neilenns/CJ4-MFD-Menu-Panel/reference.png

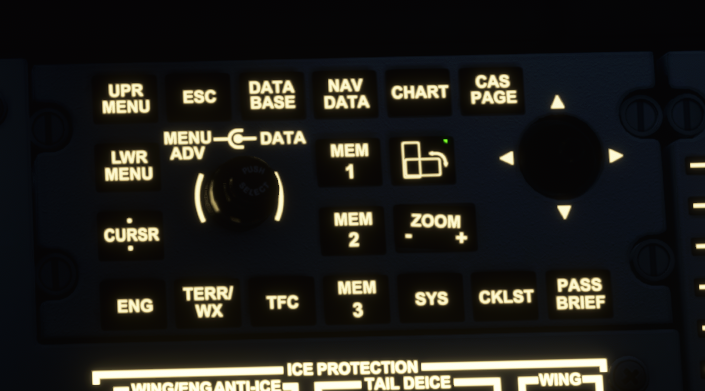
reference.png
