neilenns/CJ4-MFD-Menu-Panel/README.md

# CJ4 MFD menu panel for use with MobiFlight
