neilenns/CJ4-MFD-Menu-Panel/3D models/5-way switch.step

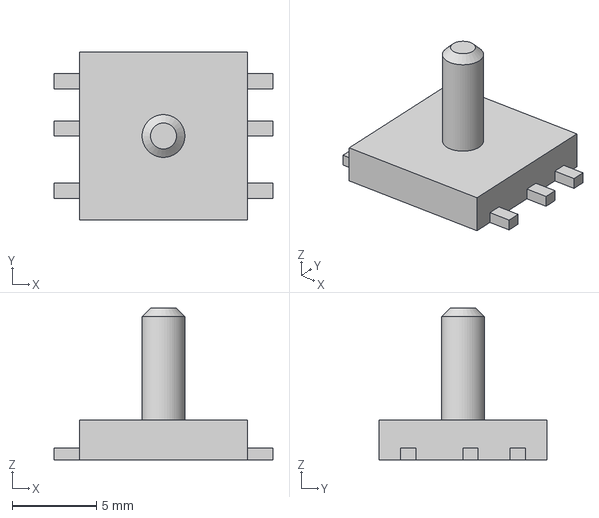
[picture p2: CAD file, 2022-09-28]
3D models/5-way switch.step
13.0 x 10.0 x 9.00 mm
