neilenns/CJ4-MFD-Menu-Panel/eec.models/ALPS_-_EC11EBB24C03.step

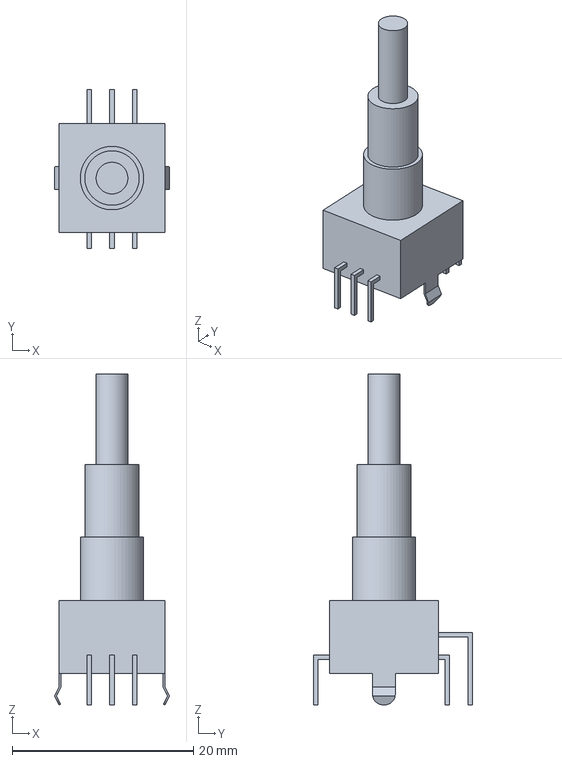
[picture p3: CAD file, 2021-12-02]
eec.models/ALPS_-_EC11EBB24C03.step
12.7 x 17.5 x 36.5 mm
