neilenns/CJ4-MFD-Menu-Panel/3D models/6x6 LED button.step

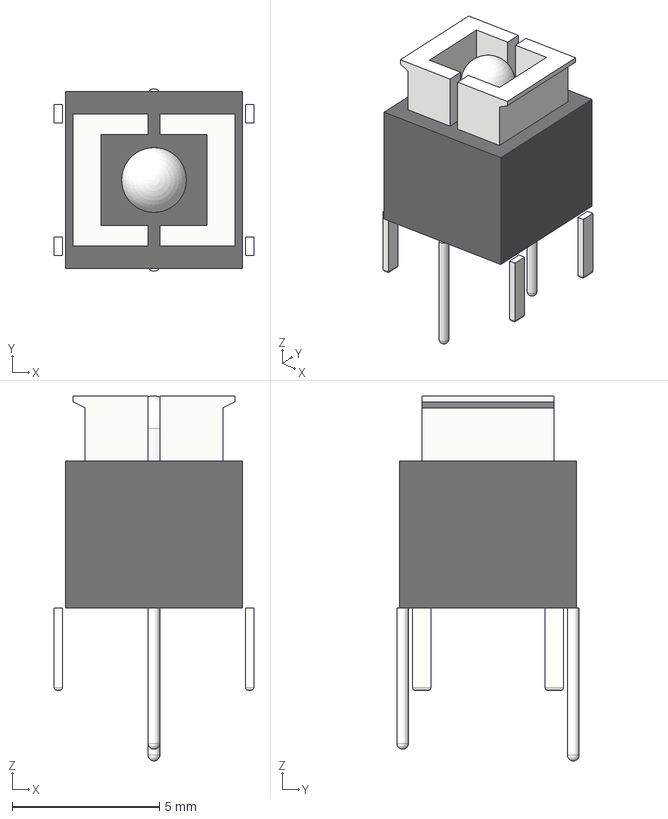
[picture p5: CAD file, 2022-09-28]
3D models/6x6 LED button.step
6.78 x 6.20 x 12.4 mm
