neilenns/CJ4-MFD-Menu-Panel/CJ4-MFD-Menu-Panel.kicad_pcb

## KiCad design CJ4-MFD-Menu-Panel.kicad_pcb (2022-09-28)

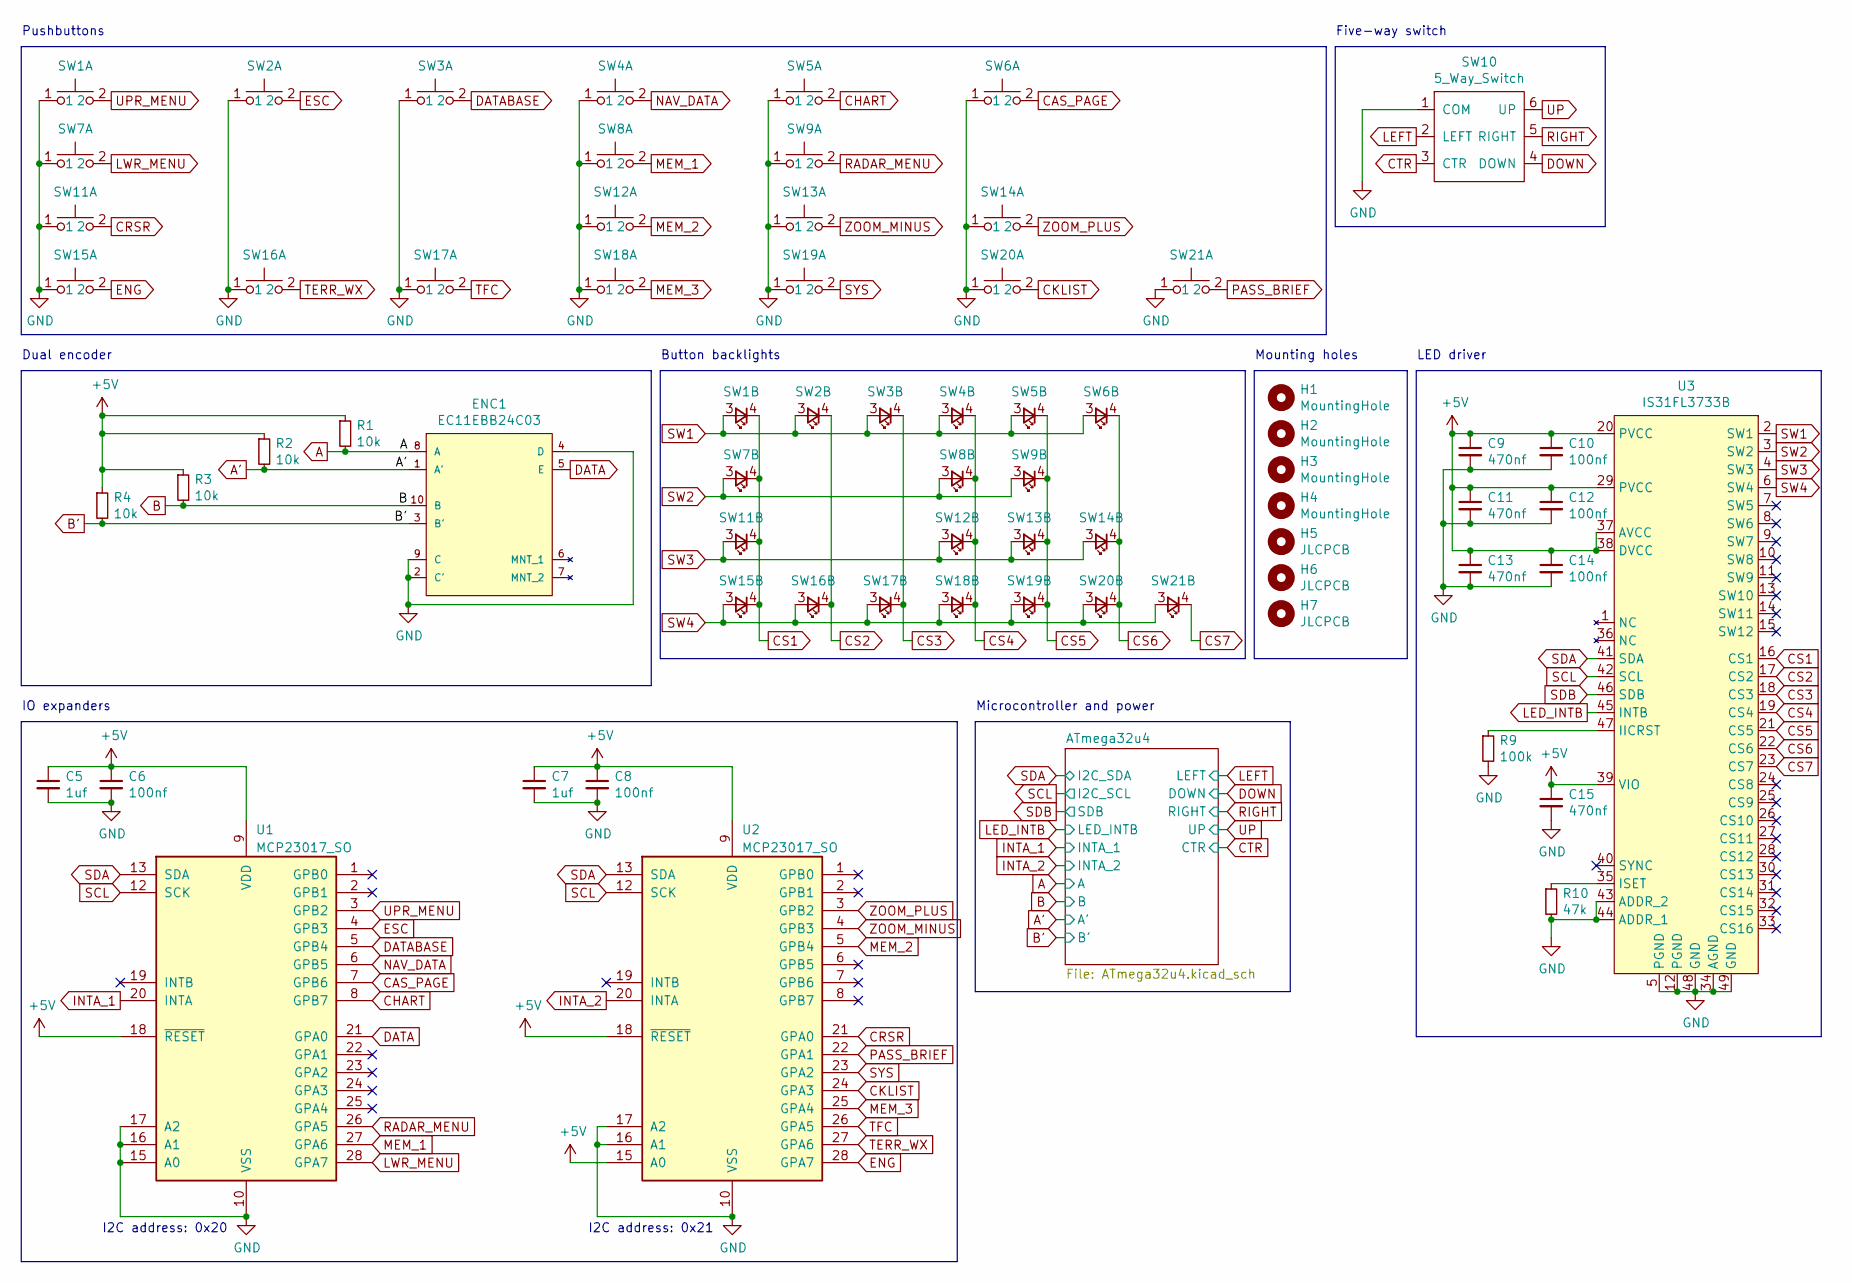
[picture p6: schematic CJ4-MFD-Menu-Panel.kicad_sch]

Parts:
C5, C7: 1uf; Perfect_0402; JLC 0402
C6, C8, C10, C12, C14: 100nf; Perfect_0402; JLC 0402
C9, C11, C13, C15: 470nf; Perfect_0402; JLC 0402
ENC1: EC11EBB24C03; ALPS-EC11EBB24C03-0; Rating 10mA 5VDC; mouser part number 688-EC11EBB24C03
H1, H2, H3, H4: MountingHole; MountingHole_3.2mm_M3; JLC DNP
H5, H6, H7: JLCPCB; JLCPCB_Tooling_Hole; JLC DNP
R1, R2, R3, R4: 10k; Perfect_0402; JLC 0402
R9: 100k; Perfect_0402; JLC 0402
R10: 47k; Perfect_0402; JLC 0402
SW1, SW2, SW3, SW4, SW5, SW6, SW7, SW8, SW9, SW11, SW12, SW13, SW14, SW15, SW16, SW17, SW18, SW19, SW20, SW21: SW_Push_LED; SW_PUSH_6mm; JLC DNP
SW10: 5_Way_Switch; JLC DNP
U1, U2: MCP23017_SO; SOIC-28W_7.5x17.9mm_P1.27mm; JLC DNP
U3: IS31FL3733B; TQFP-48-1EP_7x7mm_P0.5mm_EP5x5mm_ThermalVias; JLC DNP

Connections:
+5V: C5.1, C6.1, C7.1, C8.1, C9.1, C10.1, C11.1, C12.1, C13.1, C14.1, C15.1, R1.1, R2.1, R3.1, R4.1, U1.9 (VDD), U1.18 (~RESET), U2.9 (VDD), U2.15 (A0), U2.18 (~RESET), U3.20 (PVCC), U3.29 (PVCC), U3.37 (AVCC), U3.38 (DVCC), U3.39 (VIO); also elsewhere on the board
A: ENC1.8 (A), R1.2; also elsewhere on the board
A': ENC1.1 (A'), R2.2; also elsewhere on the board
B: ENC1.10 (B), R3.2; also elsewhere on the board
B': ENC1.3 (B'), R4.2; also elsewhere on the board
CAS_PAGE: SW6.2, U1.7 (GPB6)
CHART: SW5.2, U1.8 (GPB7)
CKLIST: SW20.2, U2.24 (GPA3)
CRSR: SW11.2, U2.21 (GPA0)
CS1: SW1.4, SW7.4, SW11.4, SW15.4, U3.16 (CS1)
CS2: SW2.4, SW16.4, U3.17 (CS2)
CS3: SW3.4, SW17.4, U3.18 (CS3)
CS4: SW4.4, SW8.4, SW12.4, SW18.4, U3.19 (CS4)
CS5: SW5.4, SW9.4, SW13.4, SW19.4, U3.21 (CS5)
CS6: SW6.4, SW14.4, SW20.4, U3.22 (CS6)
CS7: SW21.4, U3.23 (CS7)
CTR: SW10.3 (CTR); also elsewhere on the board
DATABASE: SW3.2, U1.5 (GPB4)
DOWN: SW10.4 (DOWN); also elsewhere on the board
ENG: SW15.2, U2.28 (GPA7)
ESC: SW2.2, U1.4 (GPB3)
E_BTN: ENC1.5 (E), U1.21 (GPA0)
GND: C5.2, C6.2, C7.2, C8.2, C9.2, C10.2, C11.2, C12.2, C13.2, C14.2, C15.2, ENC1.2 (C'), ENC1.4 (D), ENC1.9 (C), R9.2, R10.2, SW1.1, SW2.1, SW3.1, SW4.1, SW5.1, SW6.1, SW7.1, SW8.1, SW9.1, SW10.1 (COM), SW11.1, SW12.1, SW13.1, SW14.1, SW15.1, SW16.1, SW17.1, SW18.1, SW19.1, SW20.1, SW21.1, U1.10 (VSS), U1.15 (A0), U1.16 (A1), U1.17 (A2), U2.10 (VSS), U2.16 (A1), U2.17 (A2), U3.5 (PGND), U3.12 (PGND), U3.34 (AGND), U3.43 (ADDR_2), U3.44 (ADDR_1), U3.48 (GND), U3.49 (GND); also elsewhere on the board
INTA_1: U1.20 (INTA); also elsewhere on the board
INTA_2: U2.20 (INTA); also elsewhere on the board
LED_INTB: U3.45 (INTB); also elsewhere on the board
LEFT: SW10.2 (LEFT); also elsewhere on the board
LWR_MENU: SW7.2, U1.28 (GPA7)
MEM_1: SW8.2, U1.27 (GPA6)
MEM_2: SW12.2, U2.5 (GPB4)
MEM_3: SW18.2, U2.25 (GPA4)
NAV_DATA: SW4.2, U1.6 (GPB5)
unnamed: R9.1, U3.47 (IICRST)
unnamed: R10.1, U3.35 (ISET)
PASS_BRIEF: SW21.2, U2.22 (GPA1)
RADAR_MENU: SW9.2, U1.26 (GPA5)
RIGHT: SW10.5 (RIGHT); also elsewhere on the board
SCL: U1.12 (SCK), U2.12 (SCK), U3.42 (SCL); also elsewhere on the board
SDA: U1.13 (SDA), U2.13 (SDA), U3.41 (SDA); also elsewhere on the board
SDB: U3.46 (SDB); also elsewhere on the board
SW1: SW1.3, SW2.3, SW3.3, SW4.3, SW5.3, SW6.3, U3.2 (SW1)
SW2: SW7.3, SW8.3, SW9.3, U3.3 (SW2)
SW3: SW11.3, SW12.3, SW13.3, SW14.3, U3.4 (SW3)
SW4: SW15.3, SW16.3, SW17.3, SW18.3, SW19.3, SW20.3, SW21.3, U3.6 (SW4)
SYS: SW19.2, U2.23 (GPA2)
TERR_WX: SW16.2, U2.27 (GPA6)
TFC: SW17.2, U2.26 (GPA5)
UP: SW10.6 (UP); also elsewhere on the board
UPR_MENU: SW1.2, U1.3 (GPB2)
ZOOM_MINUS: SW13.2, U2.4 (GPB3)
ZOOM_PLUS: SW14.2, U2.3 (GPB2)

Notes on the sheet:
Pushbuttons
IO expanders
LED driver
Button backlights
Microcontroller and power
Five-way switch
Dual encoder
I2C address: 0x20
I2C address: 0x21
Mounting holes

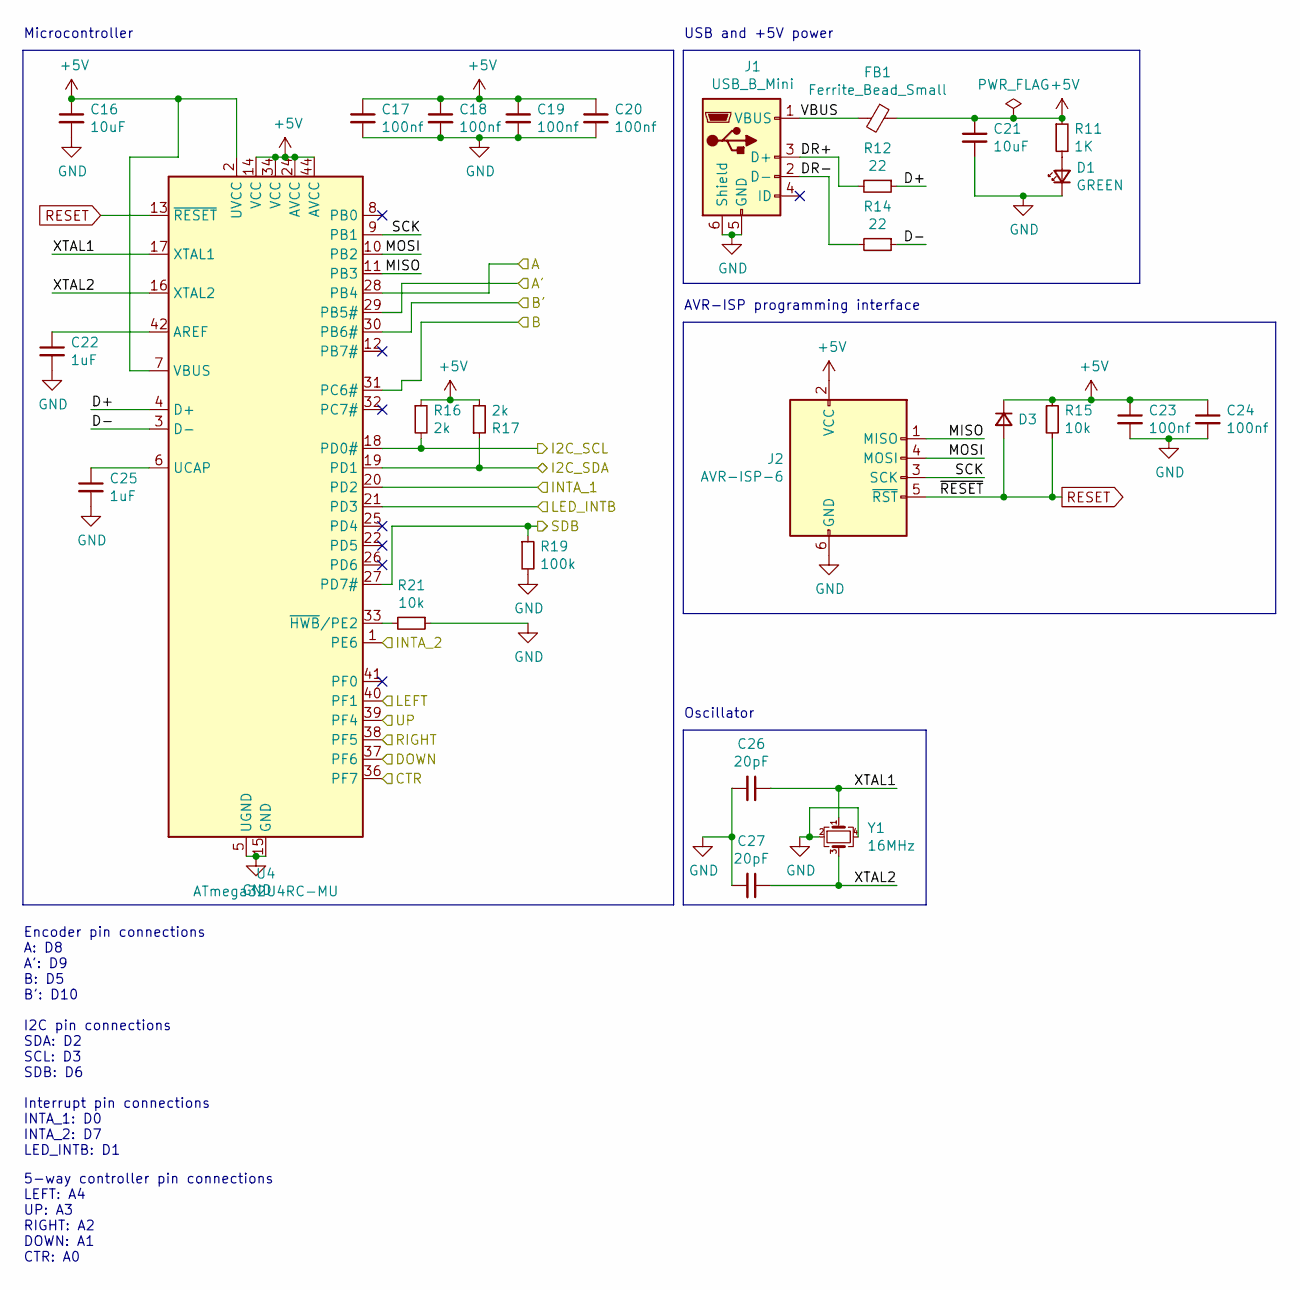
[picture p7: schematic ATmega32u4.kicad_sch]

Parts:
C16, C21: 10uF; Perfect_0402; JLC 0402
C17, C18, C19, C20, C23, C24: 100nf; Perfect_0402; JLC 0402
C22, C25: 1uF; Perfect_0402; JLC 0402
C26, C27: 20pF; Perfect_0402; JLC 0402
D1: GREEN; LED_0805_2012Metric_Pad1.15x1.40mm_HandSolder; JLC DNP
D3: D_Small; D_SOD-323F; JLC SOD-323F
FB1: Ferrite_Bead_Small; C_0805_2012Metric; JLC 0805
J1: USB_B_Mini; USB_B_Mini_Amphenol_UE25BE5510H; JLC DNP
J2: AVR-ISP-6; Tag-Connect_TC2030-IDC-NL_2x03_P1.27mm_Vertical; JLC DNP
R11: 1K; Perfect_0402; JLC 0402
R12, R14: 22; Perfect_0402; JLC 0402
R15, R21: 10k; Perfect_0402; JLC 0402
R16, R17: 2k; R_0805_2012Metric_Pad1.20x1.40mm_HandSolder; JLC 0805
R19: 100k; Perfect_0402; JLC 0402
U4: ATmega32U4RC-MU; QFN-44-1EP_7x7mm_P0.5mm_EP5.2x5.2mm; JLC DNP
Y1: 16MHz; Crystal_SMD_3225-4Pin_3.2x2.5mm; JLC SMD-CRY-3225_4P

Connections:
+5V: C16.1, C17.1, C18.1, C19.1, C20.1, C21.1, C23.1, C24.1, D3.1 (K), FB1.1, J2.2 (VCC), R11.1, R15.1, R16.1, R17.2, U4.2 (UVCC), U4.7 (VBUS), U4.14 (VCC), U4.24 (AVCC), U4.34 (VCC), U4.44 (AVCC); also elsewhere on the board
/ATmega32u4/D+: R12.1, U4.4 (D+)
/ATmega32u4/D-: R14.1, U4.3 (D-)
/ATmega32u4/DR+: J1.3 (D+), R12.2
/ATmega32u4/DR-: J1.2 (D-), R14.2
/ATmega32u4/MISO: J2.1 (MISO), U4.11 (PB3)
/ATmega32u4/MOSI: J2.4 (MOSI), U4.10 (PB2)
/ATmega32u4/SCK: J2.3 (SCK), U4.9 (PB1)
/ATmega32u4/VBUS: FB1.2, J1.1 (VBUS)
/ATmega32u4/XTAL1: C26.1, U4.17 (XTAL1), Y1.1
/ATmega32u4/XTAL2: C27.1, U4.16 (XTAL2), Y1.3
A: U4.28 (PB4); also elsewhere on the board
A': U4.29 (PB5#); also elsewhere on the board
B: U4.31 (PC6#); also elsewhere on the board
B': U4.30 (PB6#); also elsewhere on the board
CTR: U4.36 (PF7); also elsewhere on the board
DOWN: U4.37 (PF6); also elsewhere on the board
GND: C16.2, C17.2, C18.2, C19.2, C20.2, C21.2, C22.2, C23.2, C24.2, C25.2, C26.2, C27.2, D1.1 (K), J1.5 (GND), J1.6 (Shield), J2.6 (GND), R19.2, R21.1, U4.5 (UGND), U4.15 (GND), U4.23 (GND), U4.35 (GND), U4.43 (GND), U4.45 (GND), Y1.2, Y1.4; also elsewhere on the board
INTA_1: U4.20 (PD2); also elsewhere on the board
INTA_2: U4.1 (PE6); also elsewhere on the board
LED_INTB: U4.21 (PD3); also elsewhere on the board
LEFT: U4.40 (PF1); also elsewhere on the board
unnamed: C22.1, U4.42 (AREF)
unnamed: C25.1, U4.6 (UCAP)
unnamed: D1.2 (A), R11.2
unnamed: R21.2, U4.33 (~HWB/PE2)
RESET: D3.2 (A), J2.5 (~RST), R15.2, U4.13 (~RESET)
RIGHT: U4.38 (PF5); also elsewhere on the board
SCL: R16.2, U4.18 (PD0#); also elsewhere on the board
SDA: R17.1, U4.19 (PD1); also elsewhere on the board
SDB: R19.1, U4.27 (PD7#); also elsewhere on the board
UP: U4.39 (PF4); also elsewhere on the board

Notes on the sheet:
USB and +5V power
I2C pin connections SDA: D2 SCL: D3 SDB: D6
Encoder pin connections A: D8 A': D9 B: D5 B': D10
AVR-ISP programming interface
Microcontroller
Oscillator
5-way controller pin connections LEFT: A4 UP: A3 RIGHT: A2 DOWN: A1 CTR: A0
Interrupt pin connections INTA_1: D0 INTA_2: D7 LED_INTB: D1

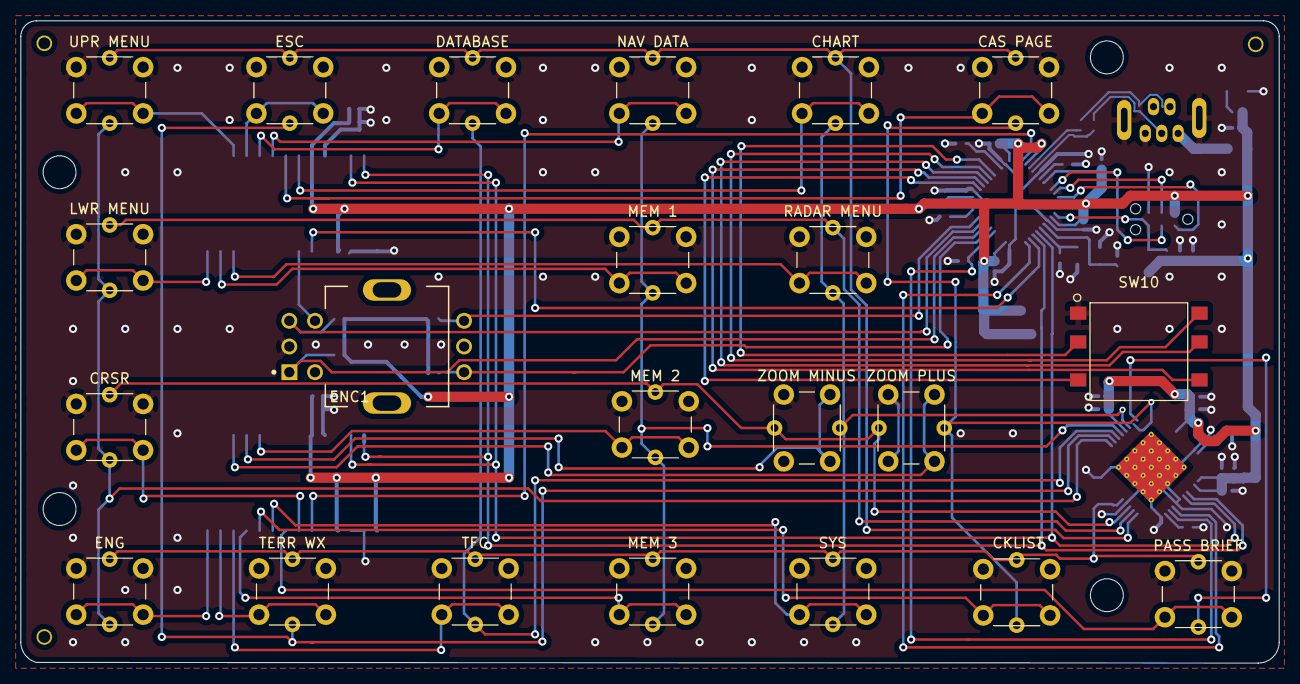
[picture p8: board CJ4-MFD-Menu-Panel.kicad_pcb from above]

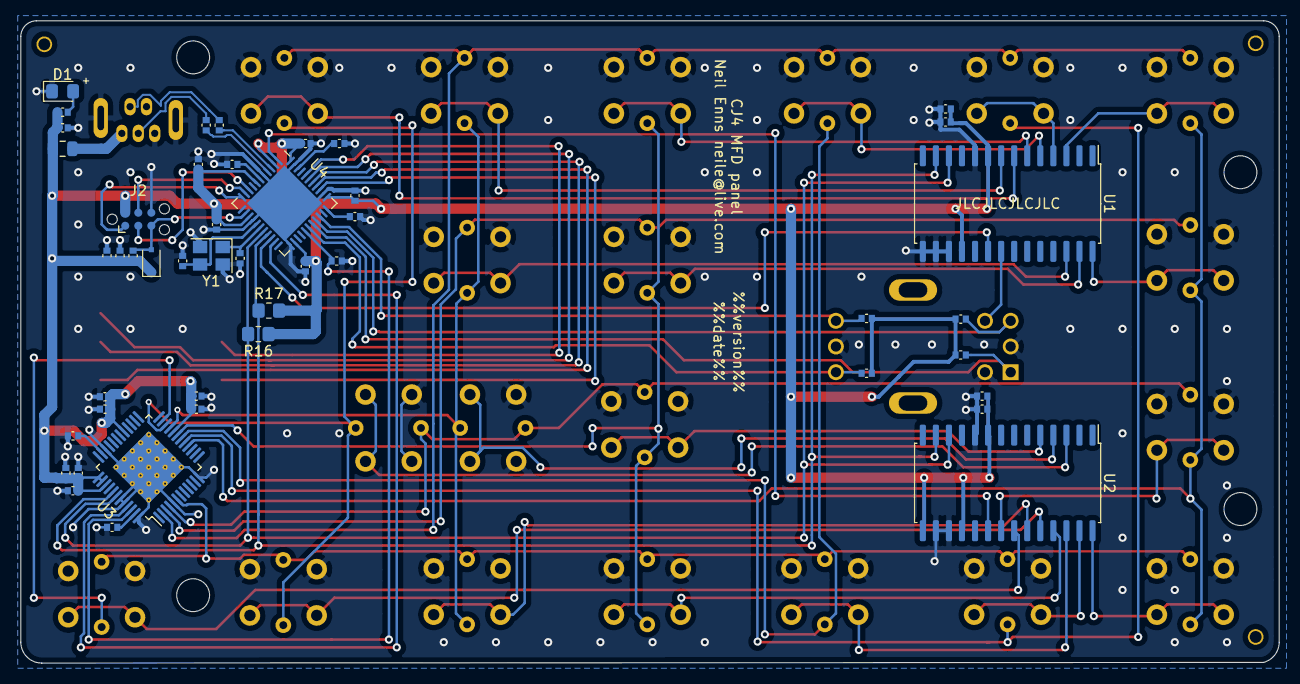
[picture p9: board CJ4-MFD-Menu-Panel.kicad_pcb from below]

Board: 2 copper layers, 122.4 x 62.5 mm, 76 parts (47 on the bottom side), 66 nets.
