neilenns/CJ4-MFD-Menu-Panel/(threads)

Thread 2 (2021-12-08):

FB1 has wrong LCSC part number

neilenns, 2021-12-08:
It has C72043 which is an LED but it should be a ferrite bead.

neilenns, 2021-12-08:
C480878 is probably the right part

Closed 2022-01-11.

Thread 4 (2021-12-18):

Capacitors are missing from JLCPCB

neilenns, 2021-12-18:
A whole bunch of the capacitors for the board are missing from the JLCPCB list.

Also some of them have the wrong footprint, they are referencing the Collins FMS footprint library instead of the CJ4-MFD-Menu.

Closed 2022-01-11.

Thread 6 (2022-01-06):

Make mounting holes on dual encoder bigger

neilenns, 2022-01-06:
They are a little too tight a fit right now.

Closed 2022-01-11.

Thread 8 (2022-01-06):

Footprint for 5-way switch is wrong

neilenns, 2022-01-06:
Pads 4 and 6 are backwards and should be swapped.

Closed 2022-01-11.

Thread 11 (2022-01-11):

PCB generation is failing due to date replacement

neilenns, 2022-01-11:
Grrrr

Closed 2022-01-11.

Thread 9 (2022-01-11):

Add quotes around version number replacement on PCB

neilenns, 2022-01-11:

Closed 2022-01-11.

Thread 13 (2022-01-13):

Clean up schematic

neilenns, 2022-01-13:
- Connect +5V directly to decoupling caps for the IO expanders
- Clean up mounting holes
- Fix whitespace

Closed 2022-01-13.
