neilenns/CJ4-MFD-Menu-Panel/(commit log)

2021-12-01 Project creation
    [CJ4-MFD-Menu-Panel.kicad_pcb, CJ4-MFD-Menu-Panel.sch]
2021-12-01 Bunch of stuff added to the schematic
    [CJ4-MFD-Menu-Panel.sch]
2021-12-02 Layout + PCB
    [ALPS_-_EC11EBB24C03.step, CJ4-MFD-Menu-Panel.kicad_pcb, CJ4-MFD-Menu-Panel.sch]
2021-12-02 Switch footprint, attempt routing
    [CJ4-MFD-Menu-Panel.kicad_pcb, CJ4-MFD-Menu-Panel.sch]
2021-12-03 Footprint changes, update board size
    [ATmega32u4.sch, CJ4-MFD-Menu-Panel.kicad_pcb, CJ4-MFD-Menu-Panel.sch]
2021-12-03 Switch to jtag
    [ATmega32u4.sch, CJ4-MFD-Menu-Panel.kicad_pcb]
2021-12-03 ATmega32u4 layout in progress
    [ATmega32u4.sch, CJ4-MFD-Menu-Panel.kicad_pcb]
2021-12-03 More routing. What a pain.
    [ATmega32u4.sch, CJ4-MFD-Menu-Panel.kicad_pcb, CJ4-MFD-Menu-Panel.sch]
2021-12-06 Partiall routed but going to rip it all up and start over
    [ATmega32u4.sch, CJ4-MFD-Menu-Panel.kicad_pcb, CJ4-MFD-Menu-Panel.sch]
2021-12-07 Fully routed and ready to go
    [ATmega32u4.sch, CJ4-MFD-Menu-Panel.kicad_pcb, CJ4-MFD-Menu-Panel.sch]
2021-12-07 Fix footprint, via errors
    [CJ4-MFD-Menu-Panel.kicad_pcb]
2021-12-07 Clean up footprint references
2022-01-11 Miscellaneous fixes
    [ATmega32u4.sch, CJ4-MFD-Menu-Panel.kicad_pcb, CJ4-MFD-Menu-Panel.sch]
2022-01-11 PCB generation is failing due to date replacement Fixes #11
    [CJ4-MFD-Menu-Panel.kicad_pcb]
2022-01-13 Clean up schematic Fixes #13
    [CJ4-MFD-Menu-Panel.sch]
2022-02-06 Fix JLCPCB part assignment
    [ATmega32u4.sch, CJ4-MFD-Menu-Panel.sch]
2022-02-07 Ready for round two
    [ATmega32u4.sch, CJ4-MFD-Menu-Panel.sch]
2022-02-11 Rename a global label to match event name
    [ATmega32u4.sch, CJ4-MFD-Menu-Panel.kicad_pcb, CJ4-MFD-Menu-Panel.sch]
2022-09-28 Update to KiCad 6, update 3D models
    [5-way switch.step, 6x6 LED button.step, ATmega32u4.kicad_sch, CJ4-MFD-Menu-Panel.kicad_pcb, CJ4-MFD-Menu-Panel.kicad_sch, UE25BE5510H--3DModel-STEP-533217.STEP]
