neilenns/CJ4-MFD-Menu-Panel/(notices)

Notices in the files:
CJ4-MFD-Menu-Panel.sch:
License: MIT
